Jinhao-cmd/casa0014-pomodoro-sunset/README.md

# Pomodoro Sunset

**A focus timer that turns the Vespera light installation into a setting sun.**

Every focus session is a "day" on Vespera: its 72 pixels go out one by one as time runs down,
a sunset sweeps across the light when the session ends, and an evening star appears for each
completed pomodoro. The timer only runs while your phone lies face down on the controller, and
it pauses when you leave your desk.

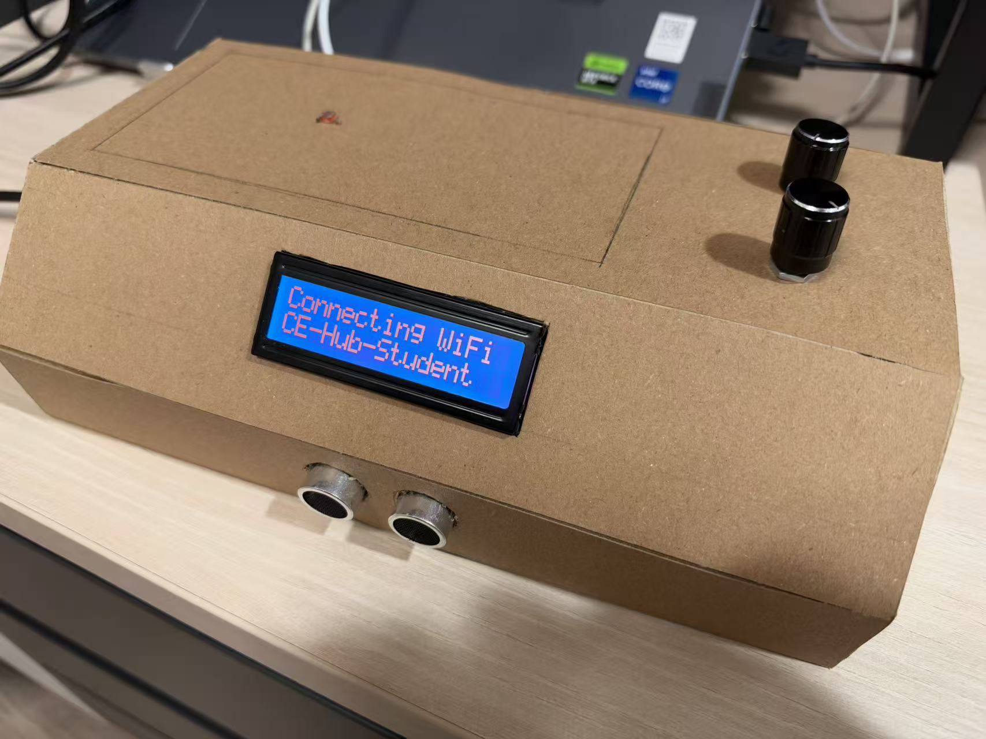
[picture p1: docs/images/enclosure/2026-11-04_enclosure-finished.jpg]
Pomodoro Sunset controller


- **Course:** CASA0014 Prototyping the Internet of Things, UCL CASA, 2026
- **Vespera luminaire:** 29 (MQTT topic `student/CASA0014/luminaire/29`)

## Development timeline

This repository was created on 29 Oct 2026, after the early prototyping. Earlier work was
committed in the order it happened; the dates below are when it was actually done, taken
from the dated photos in `docs/images/`.

| Date | Stage |
|---|---|
| 19 Oct | Concept sketch |
| 26 Oct | Hand-drawn wiring plan |
| 27 Oct | First breadboard build (v1) |
| DD Oct | Firmware rewritten as v2 after tutor feedback |
| 30 Oct | Enclosure sketch and cardboard build; LDR soldered to extension wires |
| 2 Nov | Wiring rebuilt (v2); electronics fitted into the enclosure |
| 3 Nov | Light states recorded in Lumi; sensors tested with the Serial Plotter |
| 4 Nov | Enclosure finished; system diagram |

## Contents

1. [Concept and inspiration](#1-concept-and-inspiration)
2. [How it works](#2-how-it-works)
3. [System design](#3-system-design)
4. [Hardware](#4-hardware)
5. [Enclosure](#5-enclosure)
6. [Software](#6-software)
7. [Build your own](#7-build-your-own)
8. [Testing and calibration](#8-testing-and-calibration)
9. [Iterations](#9-iterations)
10. [Naming conventions](#10-naming-conventions)
11. [Operational notes](#11-operational-notes)
12. [Limitations and future work](#12-limitations-and-future-work)
13. [Acknowledgements](#13-acknowledgements)

---

## 1. Concept and inspiration

*Vespera* is Latin for "evening" and the name of the evening star. The installation represents
the passage of time from day to night, so I designed a controller that is about time:
a Pomodoro timer, where each 25-minute focus session becomes a day that sets into evening.

- **The Pomodoro Technique** takes its name from a tomato-shaped kitchen timer that you twist
  to start. The rotary knob keeps that gesture.
- **A phone dock** turns starting a session into a commitment: put your phone face down to begin.
- **A shared signal:** Vespera hangs in a shared lab, so the light also tells others that
  someone is focusing.

### From tomato to desk clock

My first idea was to shape the controller like a tomato, after the original Pomodoro kitchen
timer. Without 3D printing, a rounded tomato was too hard to make from cardboard, so I based
the form on a desk clock instead: the screen is tilted so the time is easy to read, and the
flat top doubles as a platform for the phone.

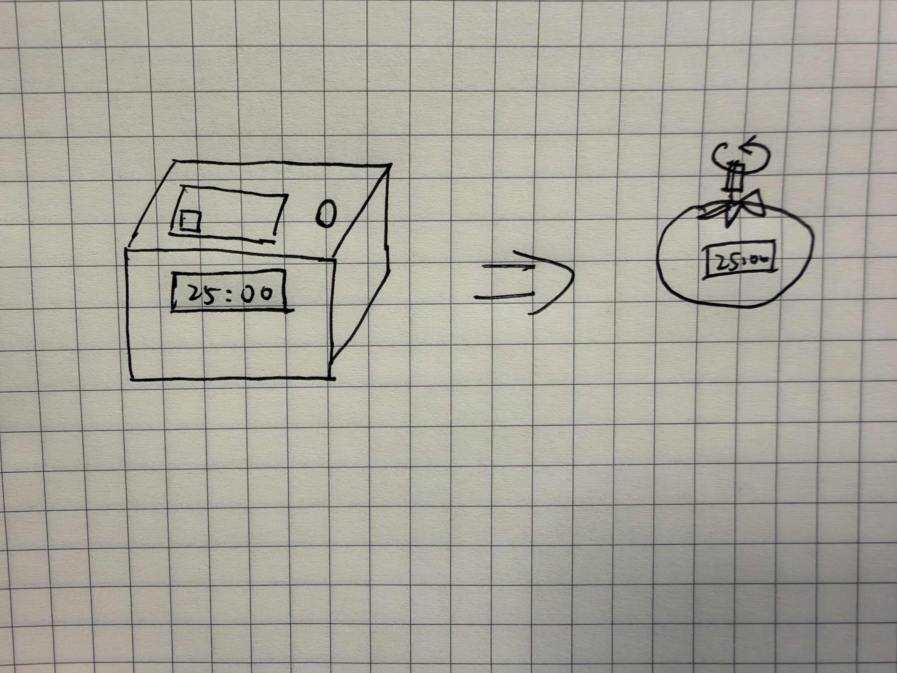
[picture p2: docs/images/sketches/2026-10-19_concept-sketch.jpg]
Concept sketch: a sloped desk console with the LCD on the slope, the LDR inside a phone area on top, two knobs, and the distance sensor on the front


The sketch places each sensor where it is used: the distance sensor on the front facing the
user, the LCD on the slope, and the LDR in the phone area on top, next to the two knobs.

## 2. How it works

| Action | What happens |
|---|---|
| Turn the knob | Choose the focus length (5-60 min); Vespera previews it |
| Press the knob | Start, pause or resume; skips a break |
| Hold the knob for 1.5 s | Reset |
| Lift your phone from the dock | Timer pauses, Vespera pulses orange, an interruption is counted |
| Leave your desk | Timer pauses until you come back |
| Turn the small knob | Brightness of Vespera and the screen |

| Stage | Vespera | LCD |
|---|---|---|
| Focus | Deep amber; one pixel goes out roughly every 21 s | `Focus 18:42` |
| Last minute | The remaining "sun" pulses | Countdown |
| End of focus | Sunset sweep, then an evening star appears | `Focus complete!` |
| Break | Blue countdown under the stars | `Break 04:12` |
| Four pomodoros | Long break under a full night sky | `Long brk` |

## 3. System design

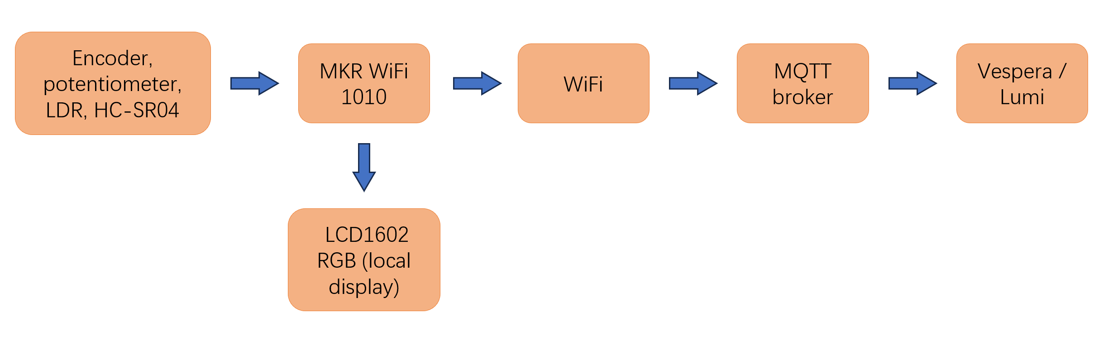
[picture p3: docs/images/diagrams/2026-11-04_system-diagram.png]
System diagram: sensors to MKR WiFi 1010, which drives the LCD and publishes over WiFi to the MQTT broker, which sends frames to Vespera and Lumi


- **Broker:** `mqtt.cetools.org`, port 1884
- **Topic:** `student/CASA0014/luminaire/29` (the only topic this device publishes to)
- **Payload:** 216 bytes = R, G, B for each of the 72 pixels, sent as one message per frame
- **Rate:** at most 5 frames per second, and only when the frame changes
- **Timer:** runs locally on the board, so the countdown continues if the network drops

### Light states

One cycle as seen in the Lumi web app (luminaire 29). The states run
setup → focus → sunset → break → dawn → setup.

| 1. Setup | 2. Focus | 3. Sunset |
|---|---|---|
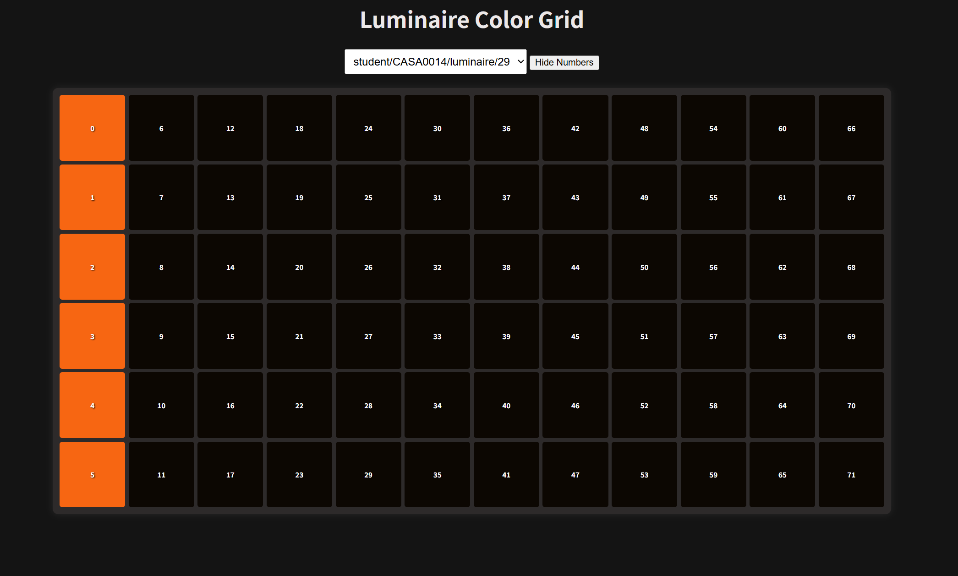
[picture p4: docs/images/states/2026-11-03_state-1-setup.png]
Setup: six pixels lit
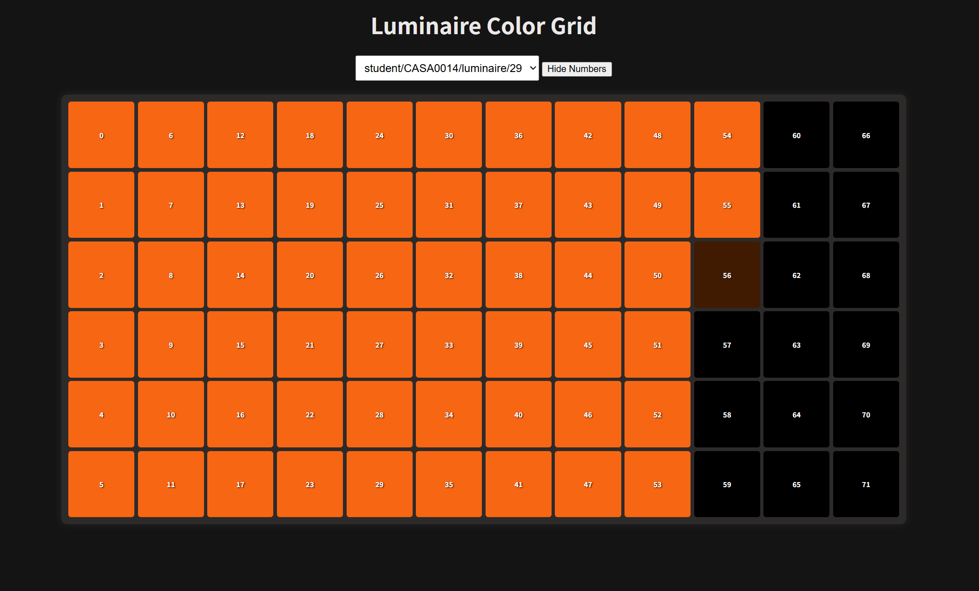
[picture p5: docs/images/states/2026-11-03_state-2-focus.png]
Focus: pixels going out one by one
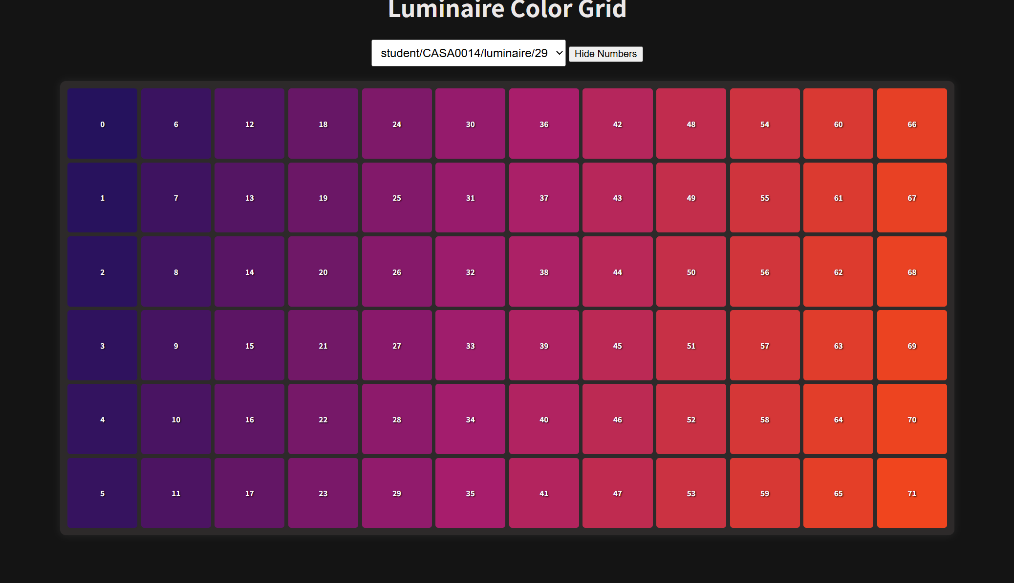
[picture p6: docs/images/states/2026-11-03_state-3-sunset.png]
Sunset gradient sweeping across the pixels
|  |  |  |
| 5 minutes chosen: 5 / 60 × 72 = 6 pixels preview the time | Pixels go out one by one; the next to go out (56) breathes | A gradient from gold to deep blue sweeps across the light |

| 4. Break | 5. Dawn |
|---|---|
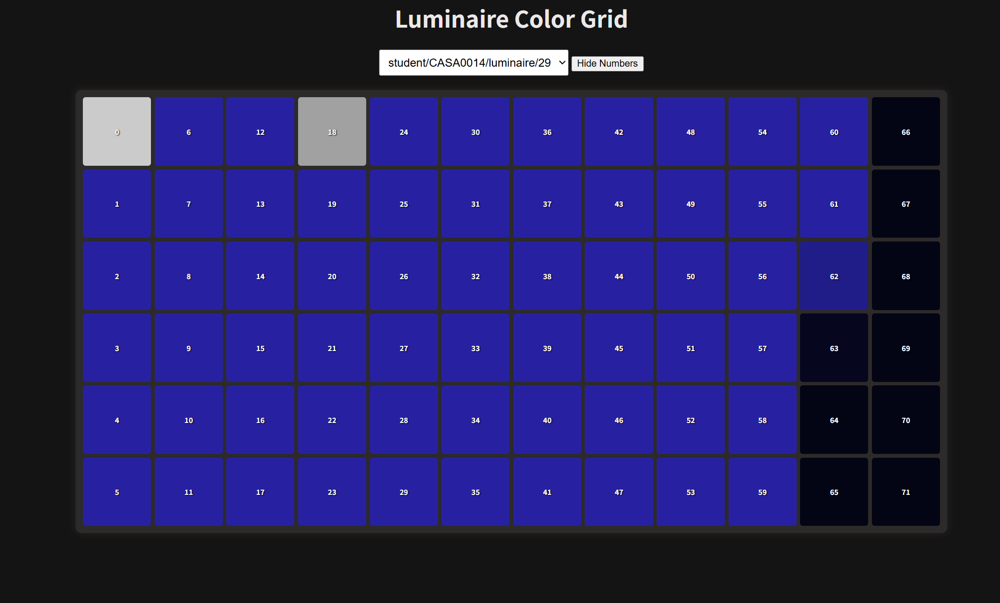
[picture p7: docs/images/states/2026-11-03_state-4-break.png]
Break: blue countdown with two white stars
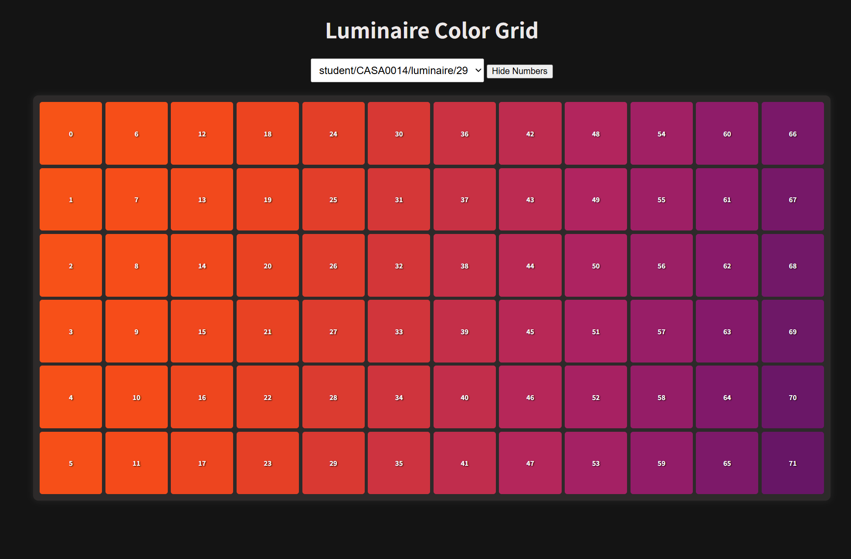
[picture p8: docs/images/states/2026-11-03_state-5-dawn.png]
Dawn: the sunset gradient in reverse
|  |  |
| Blue countdown; the two white pixels (0 and 18) are stars for two completed pomodoros | The sunset in reverse, back to setup |

## 4. Hardware

### Bill of materials

| Part | Qty | Notes |
|---|---|---|
| Arduino MKR WiFi 1010 | 1 | |
| Rotary encoder with push button | 1 | Main control |
| Potentiometer | 1 | Brightness |
| LDR (photoresistor) + 10 kΩ resistor | 1 + 1 | Phone dock |
| HC-SR04 ultrasonic sensor (5 V version) | 1 | Presence |
| 1 kΩ resistors | 3 | Voltage divider for the HC-SR04 echo pin |
| Waveshare LCD1602 RGB module | 1 | I2C |
| Breadboard and jumper wires | | |
| Cardboard, tape and a hex nut | | Enclosure; the nut holds the encoder |

### Wiring

| Part | Pin on the MKR1010 |
|---|---|
| Encoder CLK / DT / SW | 4 / 5 / 3 (encoder + to VCC) |
| Potentiometer middle leg | A1 (outer legs to VCC and GND) |
| LDR divider | VCC -> LDR -> A2 -> 10 kΩ -> GND |
| HC-SR04 VCC / Trig | 5V / 7 |
| HC-SR04 Echo | 1 kΩ + 2 kΩ divider -> 8 |
| LCD1602 RGB | VCC, GND, SDA (11), SCL (12) |

> **Warning:** the HC-SR04 echo pin outputs 5 V, but the MKR1010 pins accept only 3.3 V.
> Always use the voltage divider.

**Wiring plan (26 Oct)**, drawn before building:

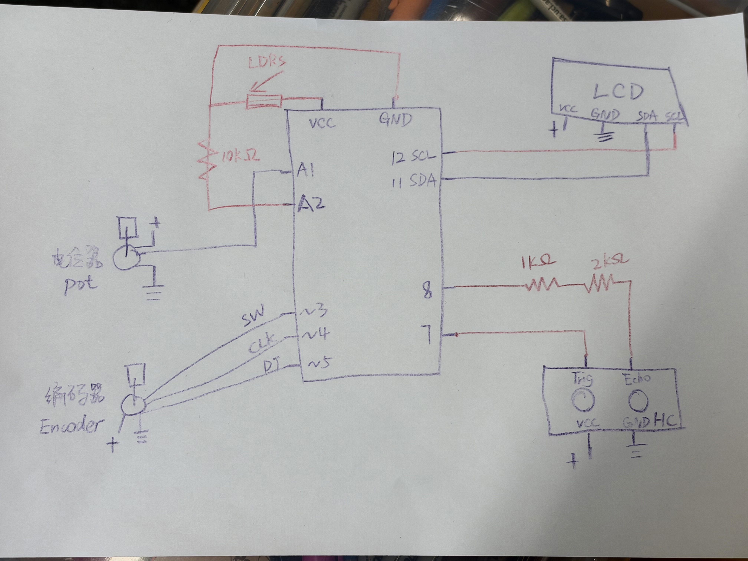
[picture p9: docs/images/wiring/2026-10-26_wiring-plan-hand-drawn.jpg]
Hand-drawn wiring plan


**Current wiring (v2, 2 Nov).** The earlier build is compared in [Iterations](#9-iterations).

Breadboard wiring v2


### Modules

| Rotary encoder | LDR phone dock | MKR WiFi 1010 |
|---|---|---|
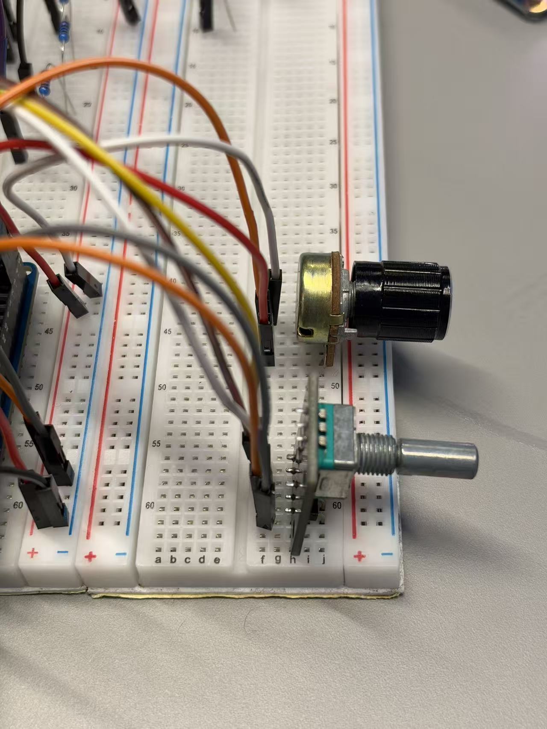
[picture p11: docs/images/modules/2026-10-27_module-encoder.jpg]
Rotary encoder on the breadboard
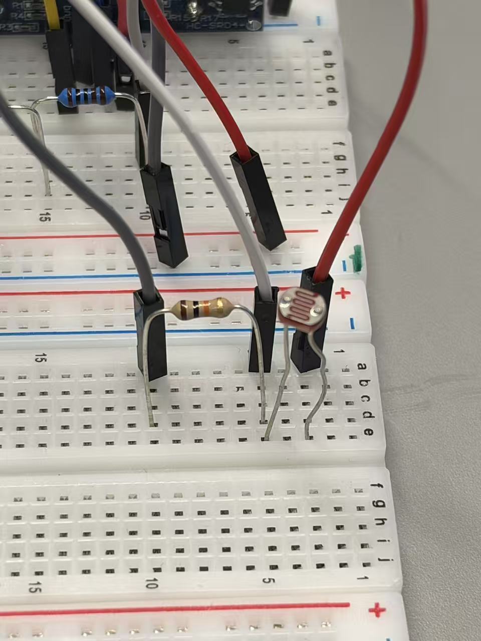
[picture p12: docs/images/modules/2026-10-27_module-ldr.jpg]
LDR with its 10k resistor
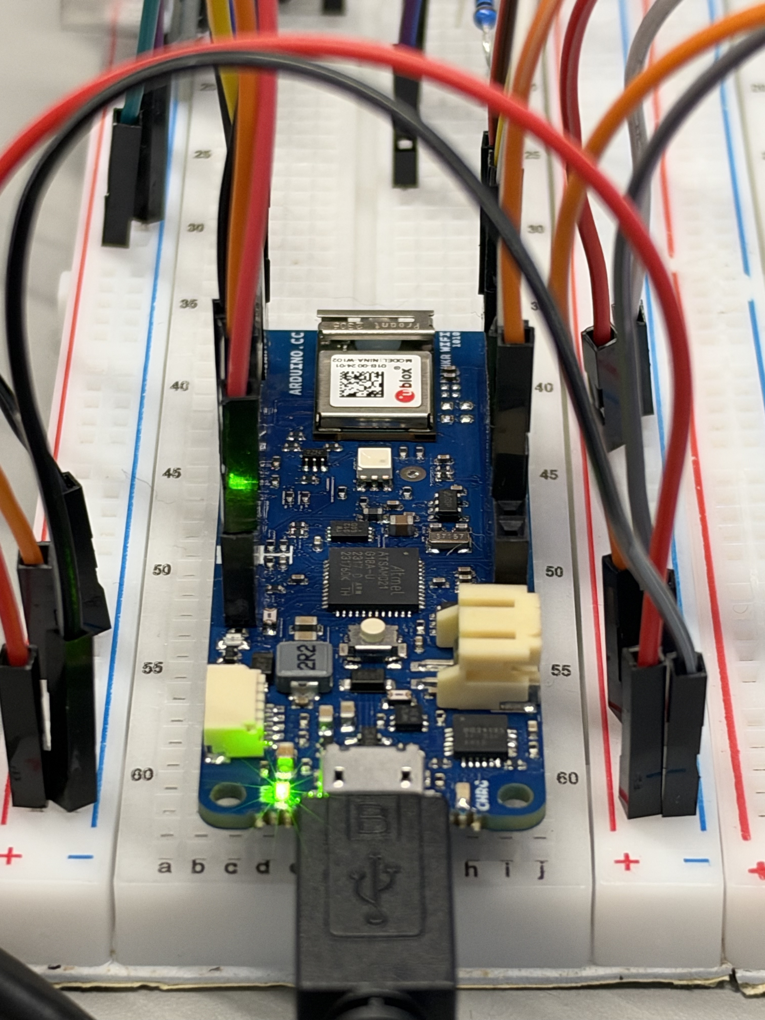
[picture p13: docs/images/modules/2026-10-27_module-mkr1010.jpg]
Arduino MKR WiFi 1010 on the breadboard
|  |  |  |
| Sets the focus time; press to start, hold to reset | Detects the phone lying face down | Reads the sensors and sends frames over WiFi / MQTT |

| Encoder and potentiometer, wired for the enclosure | LDR soldered to extension wires |
|---|---|
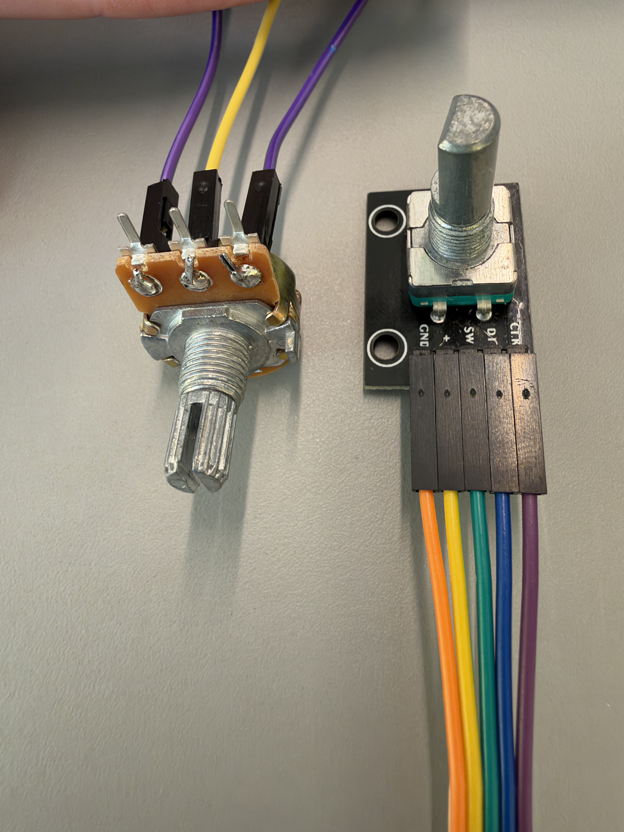
[picture p14: docs/images/wiring/2026-11-02_encoder-pot-wiring.jpg]
Encoder and potentiometer with jumper wires
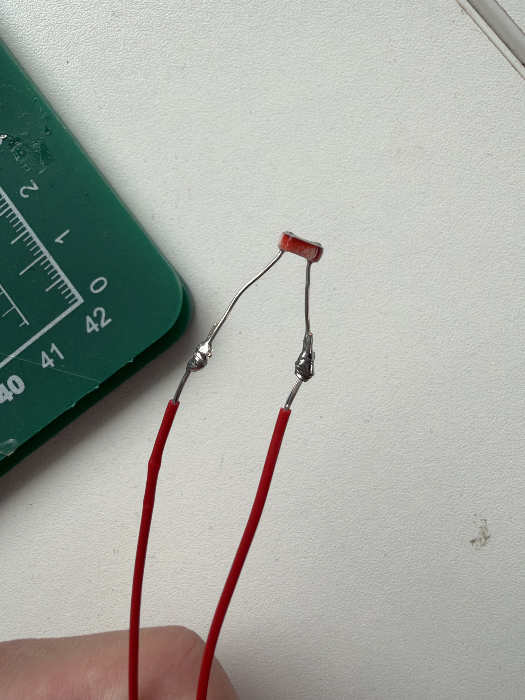
[picture p15: docs/images/modules/2026-10-30_ldr-soldered.jpg]
LDR soldered to extension wires
|  |  |

| LCD1602 RGB and HC-SR04 |
|---|
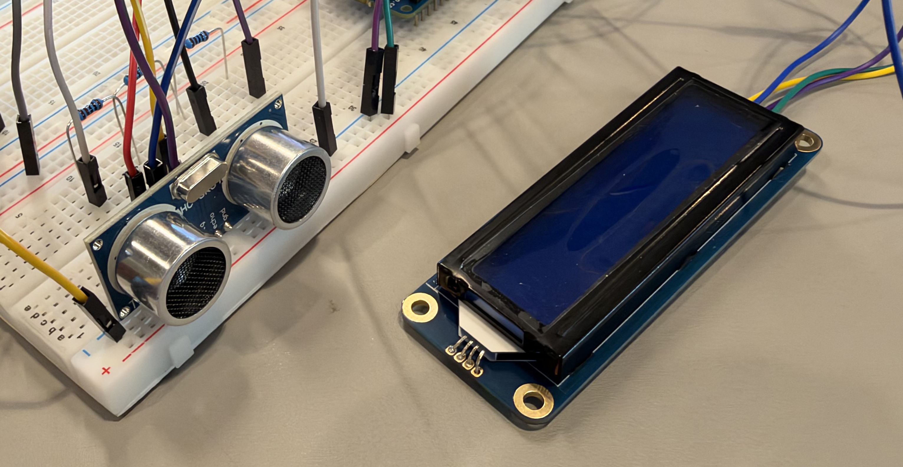
[picture p16: docs/images/modules/2026-10-27_module-lcd-hcsr04.jpg]
LCD1602 RGB module and HC-SR04 ultrasonic sensor
|  |
| The LCD shows the exact time and its backlight follows Vespera; the HC-SR04 faces the user and its echo line goes through a 1k + 2k divider |

## 5. Enclosure

A medium-fidelity cardboard enclosure: a sloped desk console with the screen on the slope,
the phone dock and knobs on the top, and the ultrasonic sensor facing the user.

| Sketch (30 Oct) | Cut panel | Empty shell |
|---|---|---|
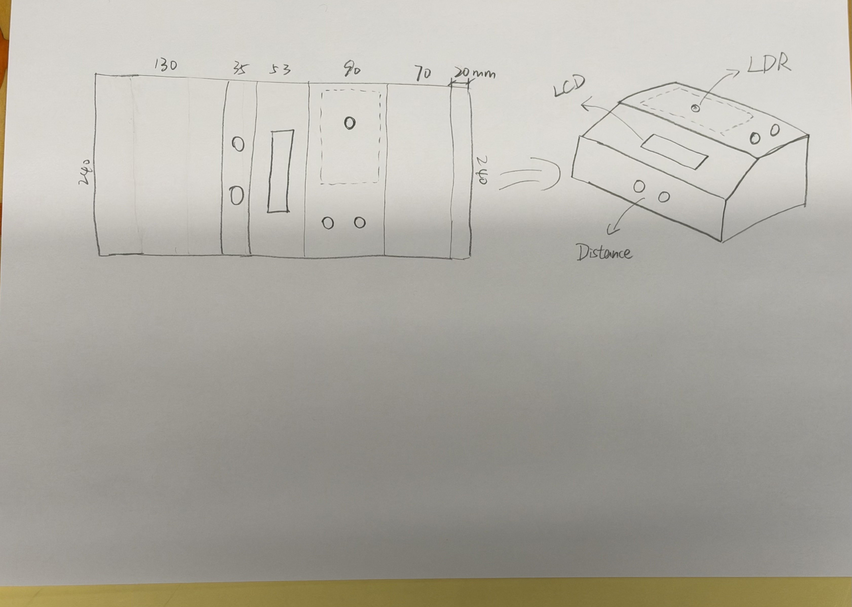
[picture p17: docs/images/enclosure/2026-10-30_enclosure-sketch.jpg]
Enclosure sketch
Cardboard panel with cut-outs for the screen and knobs
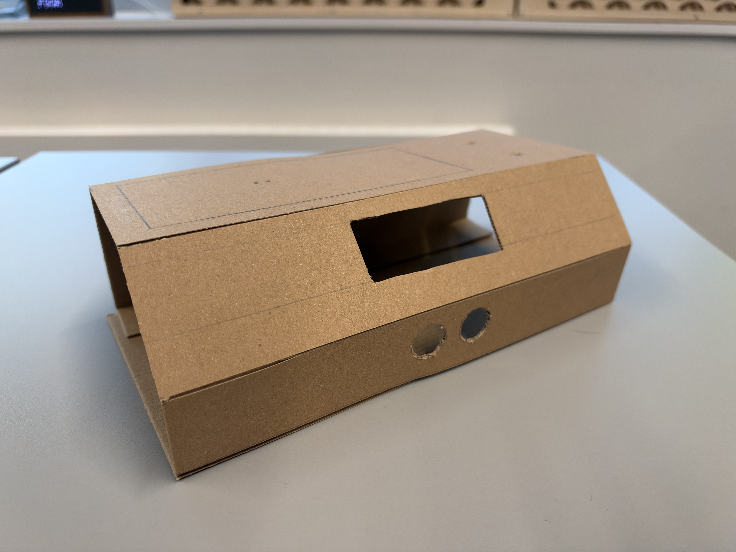
[picture p19: docs/images/enclosure/2026-10-30_enclosure-empty.jpg]
Empty cardboard enclosure
|  |  |  |
| Inspired by a desk clock: the screen is tilted so the time is easy to read, with a flat platform on top for the phone | Openings sized by measuring each part, then cut and trimmed until it fitted | The cardboard was partly cut through so it could bend at the folds; tabs were left for joining, and it was taped into shape |

| Planning the layout (2 Nov) | Wired inside |
|---|---|
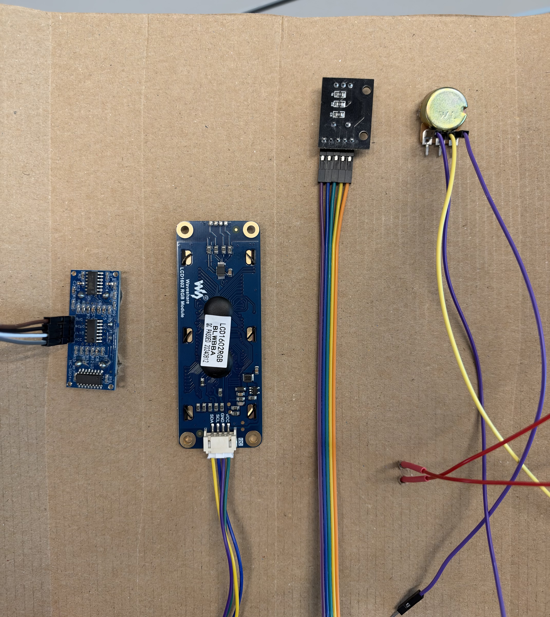
[picture p20: docs/images/enclosure/2026-11-02_enclosure-components-layout.jpg]
Components laid out on the cardboard
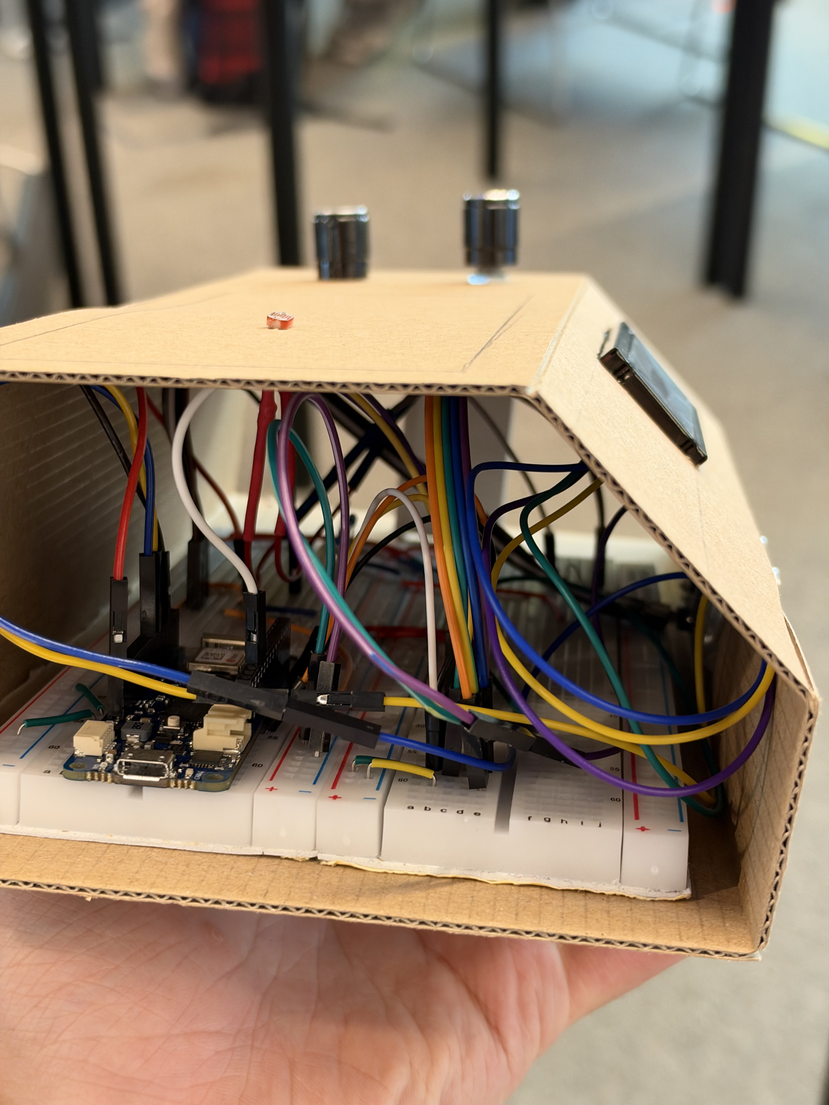
[picture p21: docs/images/wiring/2026-11-02_enclosure-inside-wiring.jpg]
Electronics wired inside the enclosure
|  |  |
| HC-SR04 at the bottom facing the user, LCD on the slope, and the LDR, encoder and potentiometer on top | Everything fitted inside the enclosure |

**Hardest part: the encoder.** Its knob is also a push button, so it needs firm support
from inside, otherwise the cardboard bends when it is pressed. It was also difficult to fix
it to the cardboard. I solved this with an internal support piece and a hex nut, which hold
the encoder firmly in the top of the enclosure.

**Finished controller**

Finished cardboard controller with all parts fitted

## 6. Software

```
firmware/pomodoro_sunset/       v1: first prototype (five tabs), superseded by v2
firmware/pomodoro_sunset_v2/
  pomodoro_sunset_v2.ino        current sketch
docs/images/                    sketches, photos, screenshots and diagrams
```

Libraries: WiFiNINA, Arduino_SpiNINA, PubSubClient (Nick O'Leary).
The LCD is driven directly over I2C, so no LCD library is needed.

Main settings at the top of the sketch:

| Setting | Purpose |
|---|---|
| `LIGHT_ID` | Vespera luminaire number |
| `DEMO_MODE` | One minute lasts 4 seconds, for demos |
| `REQUIRE_PHONE_DOCK`, `USE_PRESENCE` | Switch the phone dock and presence detection on or off while testing |
| `GENTLE_ANIMATIONS` | Breathing and pulsing effects on Vespera |
| `PHONE_ON_RATIO`, `PHONE_OFF_RATIO` | LDR thresholds for placing and lifting the phone |
| `PRESENCE_MAX_CM` | Distance below which someone counts as at the desk |
| `ENCODER_STEPS_PER_CLICK`, `ENCODER_DIRECTION` | Match the sketch to the encoder |
| `PIXEL_ORDER`, `STAR_PIXELS` | Map the animation to Vespera's physical layout |

The delay before pausing when you leave is set in `awayDelayMs()`.

## 7. Build your own

1. Wire the parts as in [Hardware](#4-hardware).
2. Clone or download this repository.
3. Install the board package and libraries listed in [Software](#6-software).
4. In `firmware/pomodoro_sunset_v2/`, create a file called `arduino_secrets.h` with your
   WiFi and MQTT details. It is listed in `.gitignore`, so it is never uploaded:

   ```cpp
   #define SECRET_SSID     "your-wifi-name"
   #define SECRET_PASS     "your-wifi-password"
   #define SECRET_MQTTUSER "your-mqtt-username"
   #define SECRET_MQTTPASS "your-mqtt-password"
   ```

5. Open `firmware/pomodoro_sunset_v2/pomodoro_sunset_v2.ino` and set `LIGHT_ID` to your own
   luminaire number.
6. Select **Arduino MKR WiFi 1010** and its port under Tools, then upload. If the upload
   fails, double-press RESET and choose the new port.
7. Keep the phone dock empty while the screen shows `Keep dock empty`.
8. Open the Serial Monitor at 9600 baud and check that it prints
   `Vespera topic: student/CASA0014/luminaire/<your id>` and `connected`.
9. Select your luminaire number in the Lumi web app, turn the knob and press it to start.

## 8. Testing and calibration

Each sensor was tested with the Serial Plotter, and the settings at the top of the sketch
were chosen from these readings.

| Sensor | Measured | Setting chosen |
|---|---|---|
| LDR phone dock | About 680 uncovered, about 15 with the phone face down in the enclosure | Docked below 75% of room light, removed above 85% |
| HC-SR04 | About 50-65 cm seated, up to 90 cm leaning back, about 120 cm after leaving | `PRESENCE_MAX_CM = 100` |
| Away delay | 10 s felt too long in testing | 4 s in demo mode, 30 s in normal mode |

| LDR: placing the phone on the dock | HC-SR04: seated, leaning back, then leaving |
|---|---|
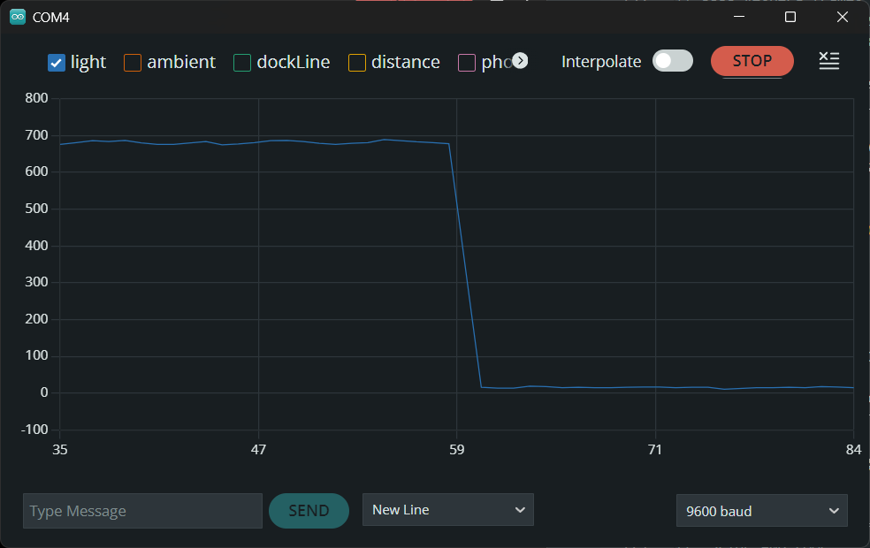
[picture p22: docs/images/testing/2026-11-03_plotter-ldr.png]
Serial Plotter: light level falls from about 680 to about 15 when the phone is placed
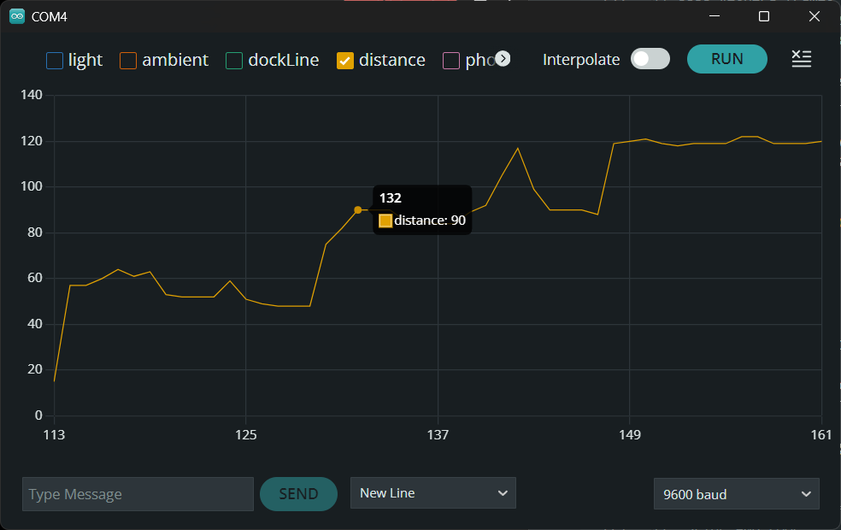
[picture p23: docs/images/testing/2026-11-03_plotter-distance.png]
Serial Plotter: distance rises from about 50 cm seated to about 120 cm after leaving
|  |  |

After leaving, the sensor reads about 120 cm rather than nothing, because it picks up the
wall or furniture behind the seat. The threshold therefore has to sit between the
leaning-back reading and this background reading.

## 9. Iterations

### Firmware v1 → v2

- **v1** (`firmware/pomodoro_sunset/`): the first full prototype, split across five
  Arduino tabs. As well as the Vespera frames, it published a JSON status topic with a
  retained "offline" last-will message.
- **Feedback:** on the shared broker, students may only publish to their own luminaire topic.
- **v2** (`firmware/pomodoro_sunset_v2/`): the status topic and last-will message were
  removed, and the tabs were merged into one file.

### LDR thresholds

The first threshold (docked below 40% of room light) never triggered: the LDR read about
700 uncovered and only about 400 covered. It was changed to 75% (docked) and 85% (removed),
leaving a gap so the reading does not flicker between the two states.

### Wiring v1 → v2

| v1 (27 Oct) | v2 (2 Nov) |
|---|---|
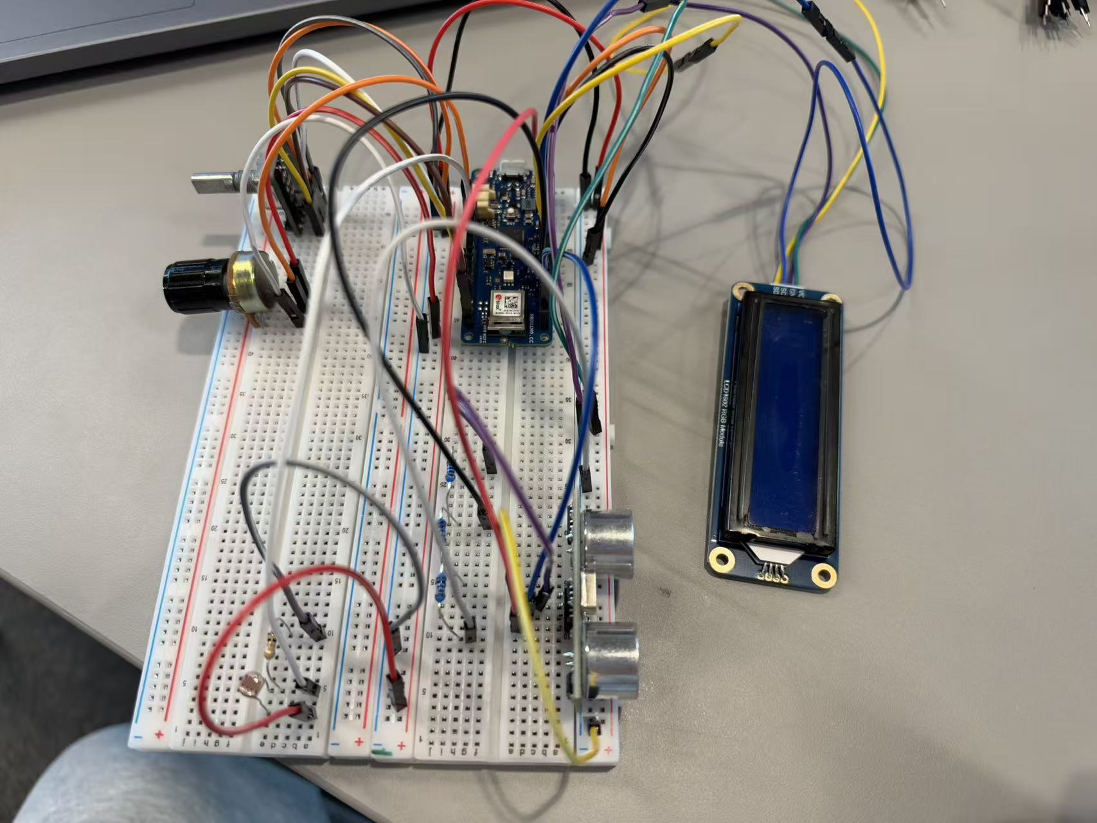
[picture p24: docs/images/wiring/2026-10-27_wiring-v1-overview.jpg]
First breadboard build
|  | Rebuilt wiring |
| Wires added one at a time, crossing over the MKR1010 | Rebuilt by zones: each group of wires leaves from its own side of the board |

### LDR moved into the enclosure

On the breadboard, the LDR's legs were too short to reach the top of the enclosure, where
the phone lies. I soldered it to longer wires so it could sit in a hole in the phone area.
This also made the dock far more reliable: on the breadboard, covering the LDR only brought
the reading down from about 700 to about 400, but in the enclosure the phone blocks almost
all light and the reading drops from about 680 to about 15. The 75% / 85% thresholds now
have a large margin.

### Presence detection

Seated, the HC-SR04 read about 50-65 cm, rising to about 90 cm when leaning back. After
leaving, it read about 120 cm, because it detects the wall or furniture behind the seat,
so `PRESENCE_MAX_CM` was set to 100, between the two. In testing, waiting 10 s before
pausing felt so long that the feature seemed broken, so the delay was shortened to 4 s in
demo mode and 30 s in normal mode, where a short movement such as turning round should
not pause the session.

### Countdown colour

The original gold (255, 150, 40) looked pale on Vespera's acrylic. Removing the blue and
lowering the green gave a deeper amber, (255, 100, 0), which reads clearly as a setting sun
(see the Focus screenshot in [Light states](#light-states)).

## 10. Naming conventions

- **MQTT:** `student/CASA0014/luminaire/<id>`, as set by the course
- **Images:** `YYYY-MM-DD_short-description` (`.jpg` for photos, `.png` for screenshots and
  diagrams), grouped by topic in `docs/images/`: `sketches`, `diagrams`, `wiring`, `modules`,
  `enclosure`, `states` and `testing`
- **Firmware:** one folder per version, named after its sketch, as Arduino requires
- **Commits:** start with a verb (`Add`, `Fix`, `Update`, `Tune`)

## 11. Operational notes

- Power from USB (computer or power bank): the HC-SR04 needs the 5 V USB supply.
- The light level is calibrated at start-up: keep the phone dock empty until the screen changes.
- The physical Vespera shows one luminaire at a time; check `"user"` in
  `student/CASA0014/luminaire/status`.

## 12. Limitations and future work

- **Light-based dock:** the LDR compares the phone to the room's light, so in a dark room it
  cannot tell whether the phone is there. A small magnet and a Hall sensor would not depend
  on lighting.
- **Presence is distance, not a person:** the HC-SR04 also sees the wall behind the seat,
  so the threshold has to be re-tuned for each desk, and soft clothing can absorb the echo.
- **Shared display:** the physical Vespera shows one luminaire at a time, so the light only
  works as a shared focus signal while it is showing luminaire 29.
- **No memory:** the timer and the star count are lost if the board loses power.
- **Pixel order:** the animation runs in Vespera's default pixel order; mapping it to the
  physical layout of the fins would make the sunset sweep more natural.
- **Privacy:** sensing presence and phone use in a shared lab raises questions about what
  is recorded; this prototype keeps everything on the device and publishes only light colours.
- **Form:** with 3D printing, the enclosure could take the tomato shape of the original
  Pomodoro timer, as first planned.

## 13. Acknowledgements

- Vespera, the Lumi web app and the workshop sketches by Duncan Wilson, UCL CASA
  Connected Environments Lab
  (<https://github.com/ucl-casa-ce/casa0014/tree/main/vespera>)
- Libraries: [WiFiNINA](https://github.com/arduino-libraries/WiFiNINA) and
  [PubSubClient](https://github.com/knolleary/pubsubclient)
- I used Claude (Anthropic) to help draft parts of the firmware and this README.
  I tested all code on the hardware, chose the design, took all measurements and photos,
  and edited the documentation in my own words.

Released under the MIT License.
