Jinhao-cmd/casa0014-pomodoro-sunset/(commit log)

2026-10-29 Create .gitignore
    Add .gitignore to keep Arduino secrets out of the repo
2026-11-03 Add wiring and module photos to README
2026-11-03 Add Pomodoro Sunset v1 firmware
    First full prototype (work from 26 Oct): rotary encoder, potentiometer,
    LDR phone dock, HC-SR04 presence, LCD1602 RGB and Vespera frames over MQTT.
    Split across five Arduino tabs.
2026-11-04 Add enclosure sketch and cardboard build photos
2026-11-04 Add wiring v2 and soldered LDR photos and enclosure assembly photos
2026-11-04 Update README with enclosure, wiring v2 and iterations
2026-11-04 Add finished enclosure and LCD / HC-SR04 photos.Add finished enclosure and module photos to README
2026-11-04 Fix system diagram: LCD connects to the MKR1010 over I2C
