Jinhao-cmd/casa0014-pomodoro-sunset/docs/images/wiring/2026-11-02_wiring-v2-overview.jpg

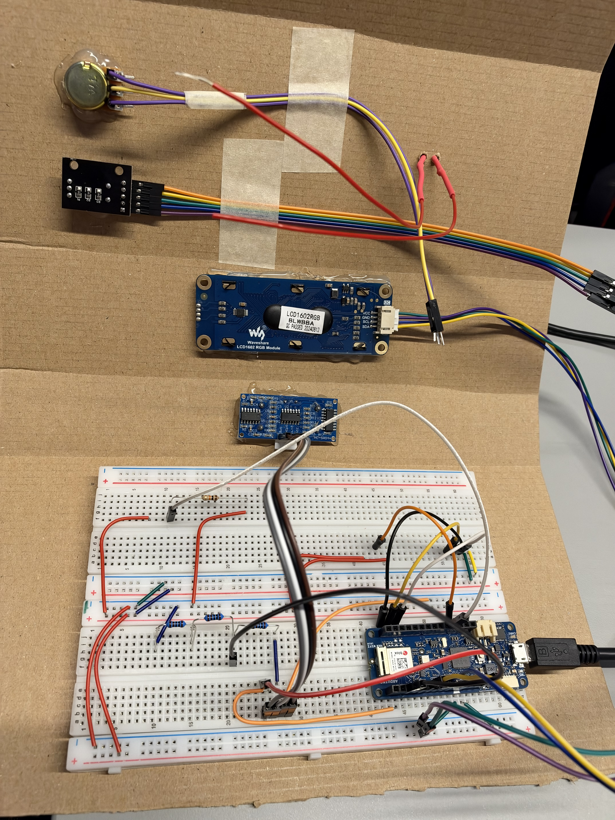
[picture p10: docs/images/wiring/2026-11-02_wiring-v2-overview.jpg]
docs/images/wiring/2026-11-02_wiring-v2-overview.jpg
