Jinhao-cmd/casa0014-pomodoro-sunset/docs/images/enclosure/2026-10-30_enclosure-panel-cut.jpg

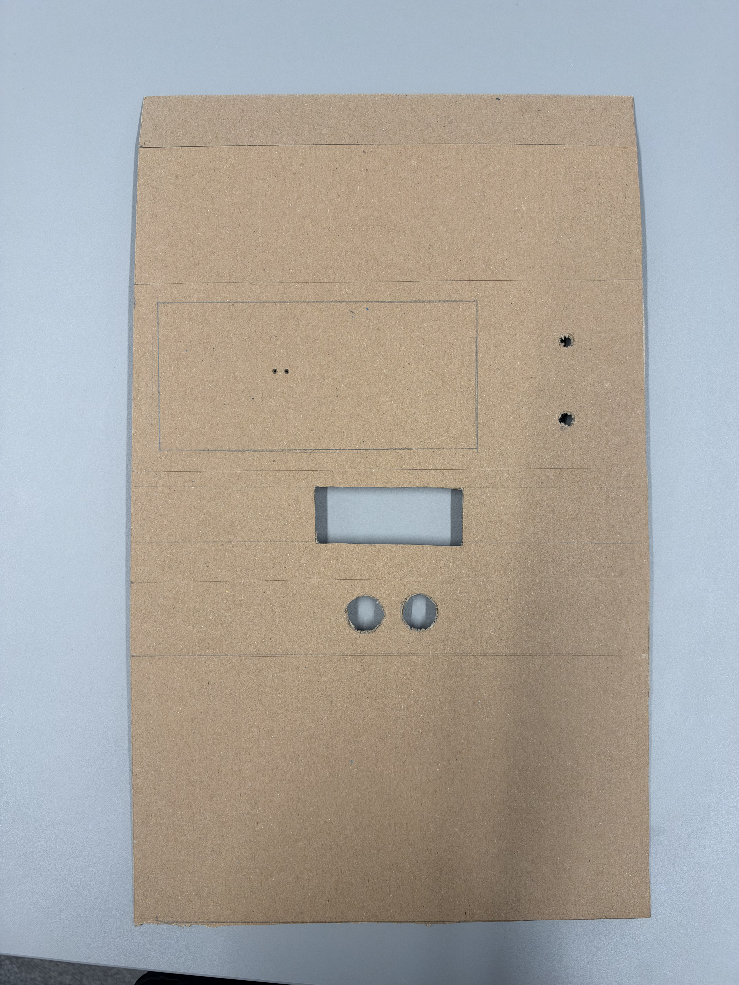
[picture p18: docs/images/enclosure/2026-10-30_enclosure-panel-cut.jpg]
docs/images/enclosure/2026-10-30_enclosure-panel-cut.jpg
